Dixhom/body-temp-prediction-thermometer/README.md

# Developing a prediction body thermometer
- Built a device to measure temperature using Arduino
- Calibrated the device
- Developed a theoretical model to predict body temperature, which wasn’t very successful

The article is `analysis.Rmd`. An html output is as follows.

http://dixhom.github.io/articles/prediction-thermometer.html

As a prelimninary experiment, the supply voltage of Arduino was measured (`measuring-arduino-vcc-internally/analysis.Rmd`).

http://dixhom.github.io/articles/get-supply-voltage-of-arduino.html
